TaigaMatsumoto/microduck/hardware/sts3032/README.md

# microduck × Feetech STS3032 換装検討

XL330-M288 を Feetech STS3032 に置き換えるための検討結果と変換マウントのCAD。
結論: **機械的には変換マウントで成立（ただし両軸版C036が前提）。電気は6V降圧が
必須、通信はバスドライバの書き換えが必要。制御はシム検証で既存ポリシーのまま
歩行・旋回・転倒復帰が成立**。

## 仕様比較

| | XL330-M288 (現行) | STS3032 |
|---|---|---|
| 外形 | 20 × 34 × 26 mm | 32 × 12 × 27.5 mm (小さい)  |
| 質量 | 18 g | 20 g (+2 g/個, 全体+30 g) |
| 電圧 | 〜6 V (実機は2S 6.6–8.2 Vで過電圧運用) | **4.8–6.0 V (2S直結不可)** |
| ストールトルク | 0.52 N·m@5 V (BAM同定では2S時±0.96 N·m相当) | **0.44 N·m@6 V (約半分)** |
| 無負荷速度 | ~104 rpm | 111 rpm@6 V |
| エンコーダ | 12bit 磁気 | 12bit 磁気 |
| 通信 | DYNAMIXEL Protocol 2.0 TTL 1 Mbps | **Feetech STS (SCS) TTL 1 Mbps — 非互換** |

## シミュレーション検証 (MuJoCo, allcollisionsモデル)

XMLアクチュエータを STS3032 相当 (forcerange ±0.44 N·m, 剛性 kp 0.25–0.45
N·m/rad, 質量+3.8%) に落として既存ONNXポリシーを実行:

| 構成 | 前進歩行(20s) | 旋回 | 転倒復帰 |
|---|---|---|---|
| XL330基準 (kp0.55 ±0.96) | 2.34 m | ○ | ○ |
| STS3032 kp0.45 ±0.44 | 2.09 m | ○ | ○ |
| STS3032 kp0.35 ±0.44 | 1.93 m | ○ | ○ |
| STS3032 kp0.25 ±0.44 | 1.25 m (ドリフト大) | △ | — |

→ トルク半減でも歩行は成立。歩速は約1割低下。実機ではBAMでSTS3032を同定して
`joints_properties.xml` にクラス追加→再学習が望ましいが、まず既存ポリシーで
動く見込みがある。

## 変換マウント (adapter_cad.py)

**前提: 両軸版 STS3032-C036 を使うこと。** 尾側の16×22×4ベアリング座 (XL330の
背面⌀16ボスの代替) はサーボ本体が軸線上を占有するためケージには作れず、後軸
に取り付けるスリーブで実現する。

| 部品 | 役割 |
|---|---|
| `cage` | XL330外形 (20×34×26, 軸位置=ホーン側端から9.5) を再現する角筒。M2×4貫通ボルト (実測: y±8 / z+7.5,−22.5, ⌀2) はそのまま流用。サーボは前面から挿入 |
| `horn_adapter` | ⌀16円盤。STSホーンに固定し、XL330ホーンパターン (4×⌀1.6下穴 @⌀12BC) を提供 |
| `tail_sleeve` | C036後軸に接着/圧入する⌀16スリーブ+フランジ。ベアリング内輪座 |

XL330側の界面寸法は `microduck_rl` の `xl330.stl` 断面解析による実測値。
STS3032側の `TODO_` 定数 (軸〜前端距離、ホーンBC、後軸径、タブ位置) は
**印刷前に必ず実物をノギスで実測して更新すること**。

既知の注意点:
- STS3032の全高27.5 > XL330奥行26。軸〜前端を8 mmとするとケース内に収まる
  計算だが、実測次第で尾側に≲1.5 mm突出しうる (シェル内クリアランス要確認)
- ホーンアダプタの円盤厚2.5 mmはXL330純正ホーンの座面高に合わせて要調整
  (駆動側リンクのオフセットがズレると関節原点がズレる)

## 機械以外の必要改修

1. **電源**: 2S (6.6–8.2 V) → 6.0 V 降圧コンバータ (連続5 A / ピーク10 A級) を
   追加。バッテリー電圧テレメトリはサーボ経由では取れなくなる (別途ADC)
2. **通信**: `duck-control/src/bus.rs` は DYNAMIXEL Protocol 2.0。Feetech STS
   レジスタマップ (Goal Position 0x2A 等) 用ドライバの追加実装が必要
3. **IMU**: `imu_to_dxl` ボードはDXLバス同居前提。STSバスとは混在不可のため
   IMUは別UARTに分離するか、ボード置き換え
4. **ゲイン**: robotdの `gain 200` はDXLレジスタ値。Feetech側の等価Pゲインは
   BAM同定 (bamはsts3215の同定例あり) で合わせ込む

## 出典

- STS3032 公称仕様 (32×12×27.5 mm / 20 g / 4.5 kg·cm@6 V / 4.8–6 V):
  Feetech公式・代理店各社の製品ページ (feetechrc.com, robotshop, switch-science)
- XL330界面寸法: 本リポジトリ経由で参照する `microduck_rl` の CADメッシュ実測

## 小型化編: STS3032に合わせて機体を縮める (scale_study.py)

「アダプタでXL330外形を維持」の対極として、機体そのものをSTS3032基準に
縮める場合の検討。

### 一様縮小はほぼ効かない

サーボの寸法比が非等方なため:

| 軸 | XL330 | STS3032 | 比 |
|----|---|---|-----|
| 幅 (脚の横幅を決める) | 20 | **12** | 0.60 |
| 長手 (リンク長を決める) | 34 | 32 | 0.94 |
| 奥行 | 26 | **27.5** | **1.06 (大きい!)** |

相似縮小の下限は最悪軸で決まり、奥行きはむしろ大きいので**単純な相似縮小は
成立しない**。現実の縮小は「レイアウト変更」が主役: 幅方向はサーボ厚12mm
を活かして大幅に痩せられる (股関節スタックの横幅 -30〜40%が狙える) 一方、
脚リンク長はサーボ全長でほぼ決まるため -5〜15%が現実的。

### スケール則 (リンク長 ×s のとき)

質量 ∝ s³、慣性 ∝ s⁵、静的必要トルク ∝ s⁴、歩行の固有振動数 ∝ 1/√s。
s=0.85 なら構造質量×0.61・必要トルク×0.52 — STS3032の0.44 N·mに対する
トルク余裕はXL330機の等価以上に回復する。**小型化はトルク半減の最良の対策
でもある**。

### シム実証: どこまで既存ポリシーが使えるか

一様スケール版MJCF (長さ×s, 質量×s³, 慣性×s⁵) + STS3032アクチュエータ
(kp0.35 ±0.44) で既存ONNXを実行:

| s | 立位10s | 歩行20s | 転倒復帰 |
|---|---|---|---|
| 1.00 | ○ | ○ 1.84 m | ○ |
| 0.90 | ○ | ○ 1.39 m | ○ |
| 0.85 | ○ | ○ 0.98 m | ○ |
| 0.80 | ○ | × 歩行が発火しない | × |
| 0.70 | ○ | × 同上 | × |

**結論: −15% (全高≈224 mm) までは既存ポリシーがそのまま動く。それ以下は
mjlabでの再学習が必須**(縮小MJCFはこのスクリプトの方法で生成できる)。

### 推奨手順

1. STS3032-C036実測 → adapter_cad.py確定 (アダプタ機で電装・ソフトを先に検証)
2. 骨格再レイアウト: 幅詰め優先・リンク長 −10〜15%、電池をNP-F550から
   小型2Sパックへ (質量見積り: 約800 g → 650–700 g)
3. 縮小MJCF生成 (scale_study.pyの変換) → BAMでSTS3032同定 →
   s<0.85を狙うならmjlab再学習、〜0.85なら既存ポリシーで起動確認から
4. 6 V電源系とFeetechバスドライバ (本編の改修リスト参照)

比較レンダ: `render_scale_compare.png` (s=1.00 vs s=0.85 vs 350ml缶)

## 再レイアウト具体案 (hip_module.py / layout_compare_front.png)

現行機のFK実測 (関節軸ワールド座標) から出発した数値レイアウト:

| 項目 | 現行 XL330 | 再レイアウト STS3032 | 差 |
|---|---|---|-----|
| 股ヨー軸間隔 | 35 mm | **26 mm** | −26% |
| ロール→ピッチ横距離 | 25 mm | 22 mm | −12% |
| 脚(ピッチ軸)間隔 | 85 mm | **70 mm** | −18% |
| 股まわり全幅 | ≈111 mm | ≈98 mm | −12% |
| 大腿/下腿リンク長 | 42.2 / 49.4 mm | ×0.88 (37.1 / 43.5) | −12% |

設計上の要点 (向きで得をする軸・しない軸):
- **ヨー軸(鉛直)・ロール軸(前後)**: サーボの12mm薄が横を向く → 大幅短縮
- **ピッチ軸(横)**: 横に出るのはサーボ高27.5mm (XL330は26) → **利得なし**。
  脚間隔短縮の主因はヨー間隔とロール段の詰めであり、当初想定の58mmは
  ここを見落とした過大見積り。70mmが正しい目標値

シム検証 (scale_studyの手法で再レイアウトMJCFを生成・既存ONNX実行):

| 構成 | 立位 | 歩行20s | 転倒復帰 |
|---|---|---|---|
| 一様 s=0.88 (脚間隔74.6) | ○ | ○ 1.27 m | ○ |
| **再レイアウト 脚間隔69.8 + s=0.88** | ○ | ○ 1.06 m | ○ |
| 再レイアウト 脚間隔75.8 + s=1.00 | ○ | ○ 1.84 m | ○ |

→ **幅−18%・リンク−12%でも既存ポリシーのまま歩行・復帰が成立**。幅詰め
単独 (s=1.00) なら歩行性能の低下ゼロ。

`hip_module.py` は左股ヨー→ロール→ピッチ3軸クラスタの概念CAD
(hip_module_assy.step)。ブラケット2点+サーボモック3個で上記レイアウトを
実体化したもの。ホーンBC等は ★要実測 のままのレイアウト検討グレード。

## 3Dプリントガイド (print_plate.py)

`print/` に印刷向きに回転済みの個別STL、`print_plate_sts3032.stl` に
全部品1プレート (159×38 mm) を出力する。QA結果: 全5部品 水密、
オーバーハングほぼゼロ、PETG想定で合計約19 g。

| 部品 | 向き | サポート | 備考 |
|---|---|---|---|
| cage | トンネル軸を鉛直 | 不要 | ボルト穴・トンネルとも垂直に出る |
| horn_adapter | XLパターン面を下 | 不要 | 座ぐりが上向き |
| tail_sleeve | フランジをベッドに | 不要 | |
| yaw_bracket | L字を寝かせて平置き | 不要 | 一定断面18mm。積層方向に強い |
| roll_bracket | ホーン円盤面を下 | seat下面のみ推奨 | |

推奨設定 (PETG または PLA+):
- レイヤー 0.16 mm / 壁 4周 (幅1.6mm — ケージ側壁3.75mmがほぼ無限壁になる)
- インフィル 40% gyroid / ブリム: cage と tail_sleeve に 3 mm
- 穴は意図的に小さめ: ⌀1.6下穴 → M2セルフタップ直入れ、⌀2.2 → M2通し。
  きつい場合は1.5/2.0mmドリルでさらい

**印刷順の推奨**:
1. **cage を先に1個** — XL330側界面は実測確定値なので、手持ちのXL330・
   既存プリント部品・M2ボルトとの嵌合確認が今すぐできる (サーボ不要)
2. horn_adapter / tail_sleeve / ブラケット2点は ★TODO_寸法 (STSホーンBC・
   後軸径など) が実測未確定。**C036現物のノギス実測 → adapter_cad.py /
   hip_module.py 更新 → 再生成してから**が確実。形状確認目的なら現状版でも可
