TaigaMatsumoto/microduck/hardware/sts3032/layout_compare_front.png

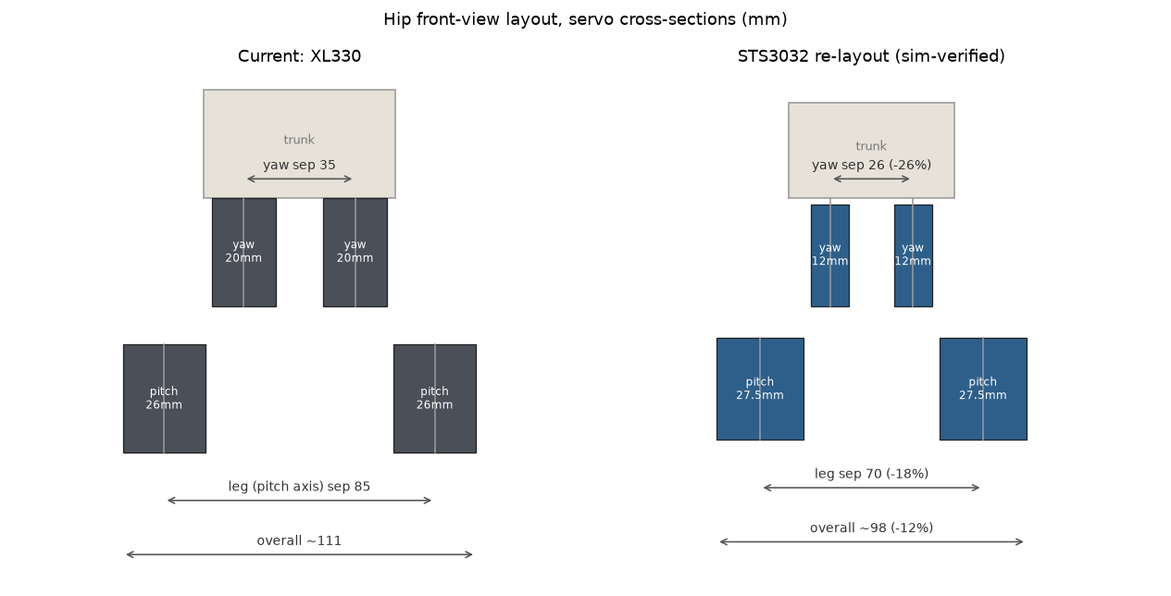
hardware/sts3032/layout_compare_front.png
