TaigaMatsumoto/microduck/hardware/sts3032/render_assy.png

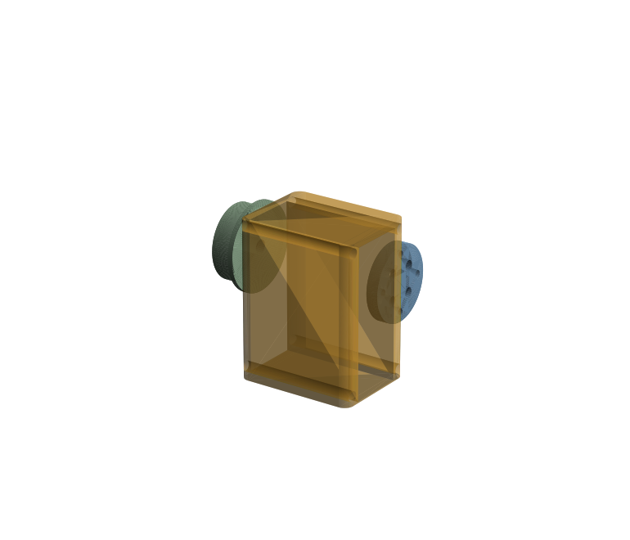
hardware/sts3032/render_assy.png
