TaigaMatsumoto/microduck/hardware/sts3032/render_cage.png

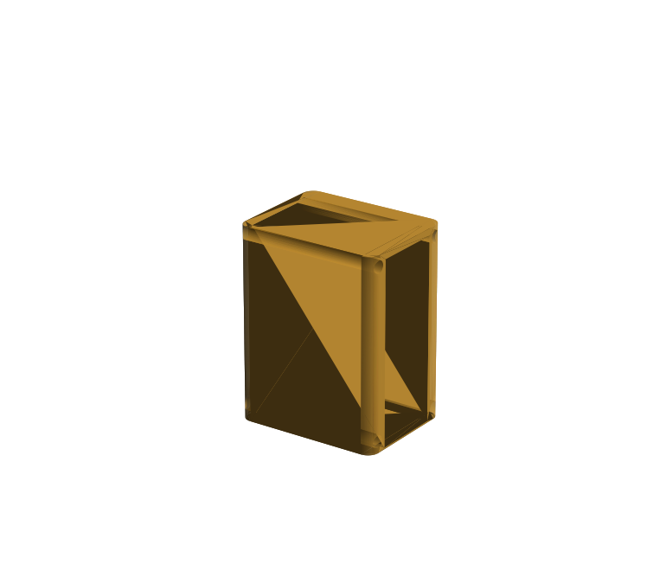
hardware/sts3032/render_cage.png
