TaigaMatsumoto/microduck/hardware/sts3032/render_full_opaque.png

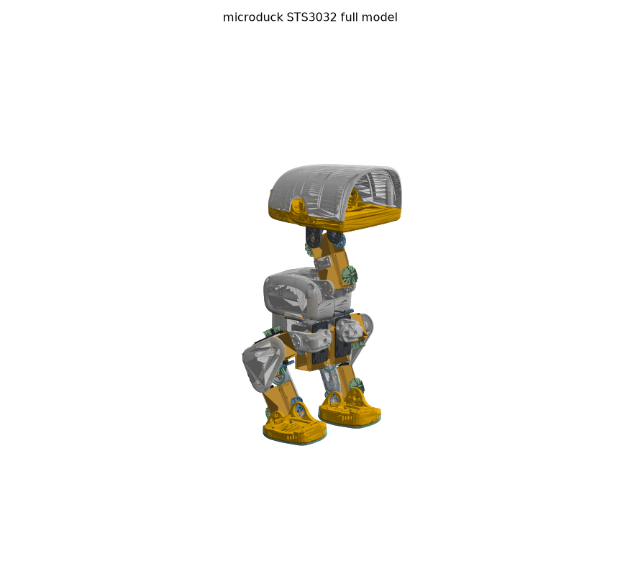
hardware/sts3032/render_full_opaque.png
