TaigaMatsumoto/microduck/hardware/sts3032/render_full_xray_front.png

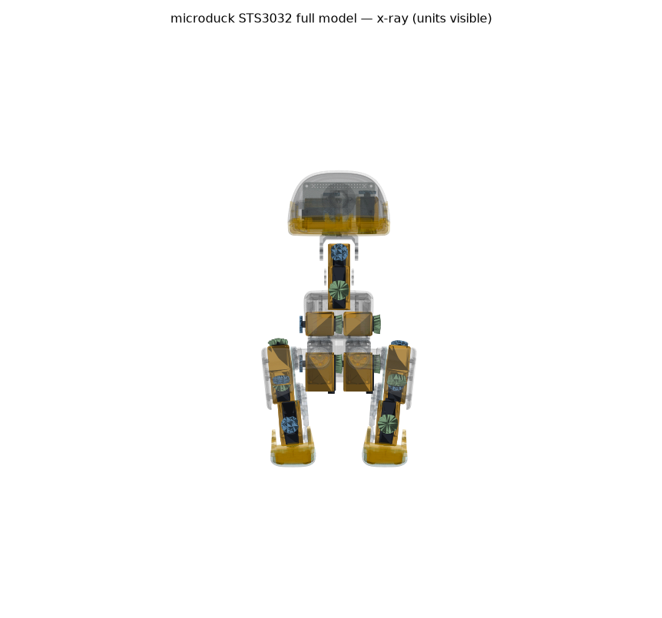
hardware/sts3032/render_full_xray_front.png
