TaigaMatsumoto/microduck/hardware/sts3032/render_hip_module.png

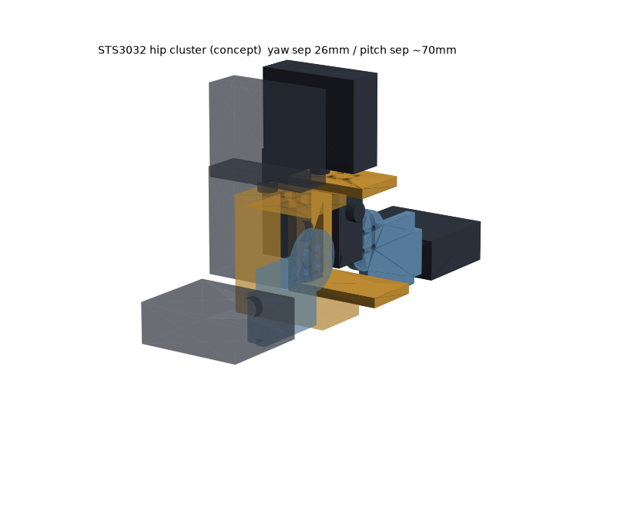
hardware/sts3032/render_hip_module.png
