TaigaMatsumoto/microduck/hardware/sts3032/render_hip_module_front.png

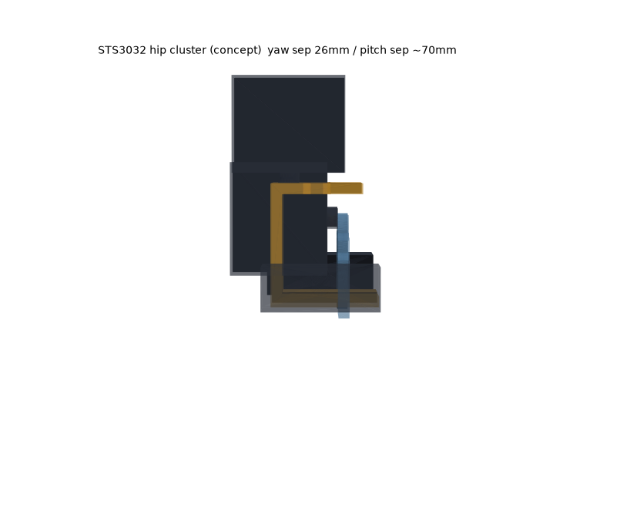
hardware/sts3032/render_hip_module_front.png
