TaigaMatsumoto/microduck/hardware/sts3032/render_scale_compare.png

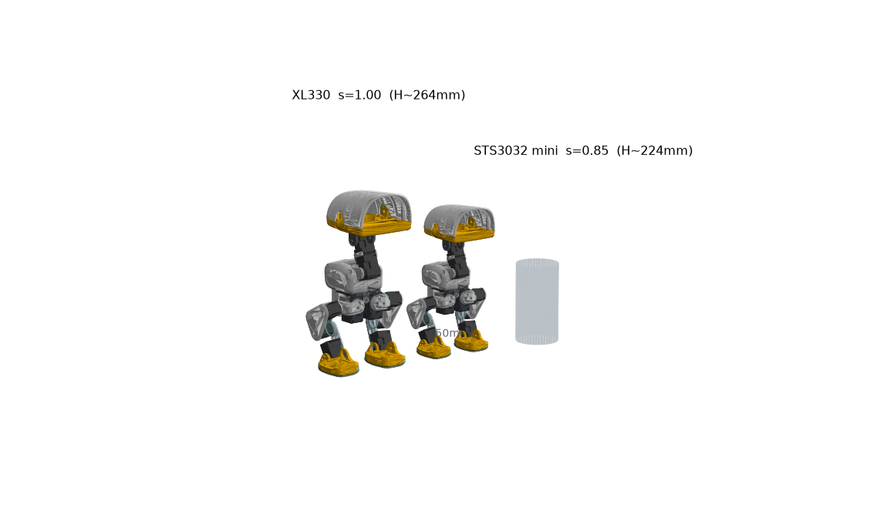
hardware/sts3032/render_scale_compare.png
