TaigaMatsumoto/microduck/hardware/sts3032/render_sleeve.png

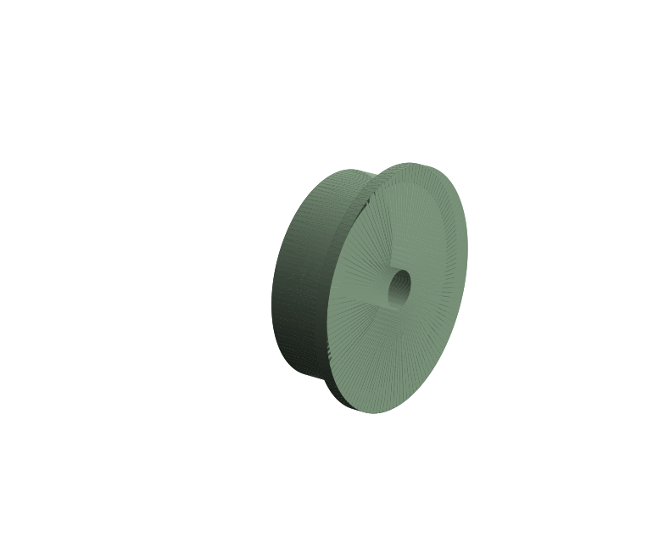
hardware/sts3032/render_sleeve.png
