TaigaMatsumoto/microduck/hardware/sts3032/hip_module_assy.step

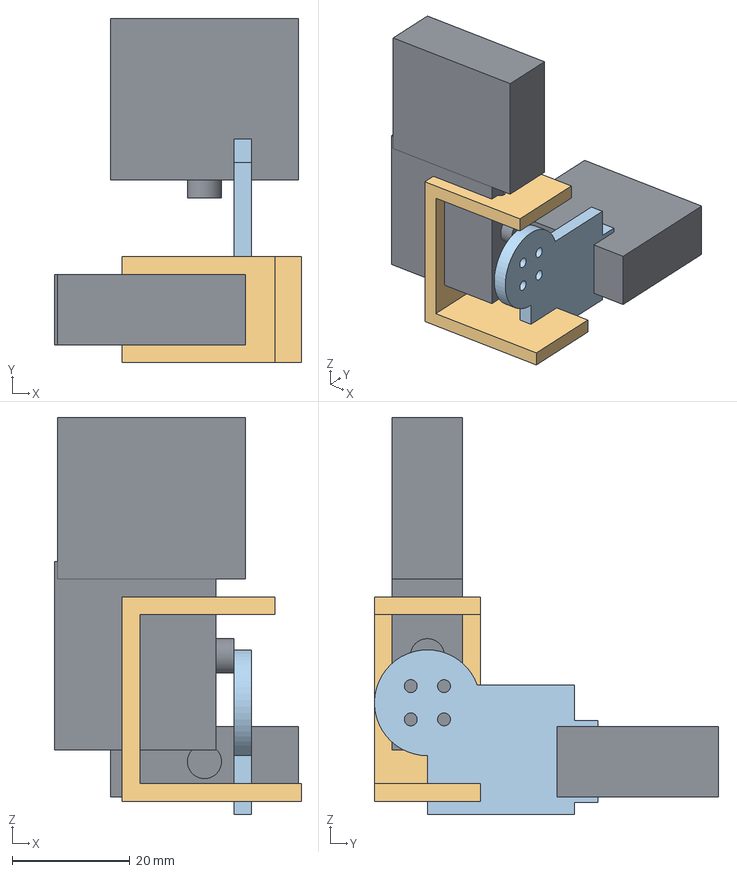
[picture p10: CAD file, 2026-08-29]
hardware/sts3032/hip_module_assy.step
42.0 x 58.5 x 67.5 mm
yaw_servo
yaw_bracket
roll_servo
roll_bracket
pitch_servo
