TaigaMatsumoto/microduck/hardware/sts3032/unit_assy.step

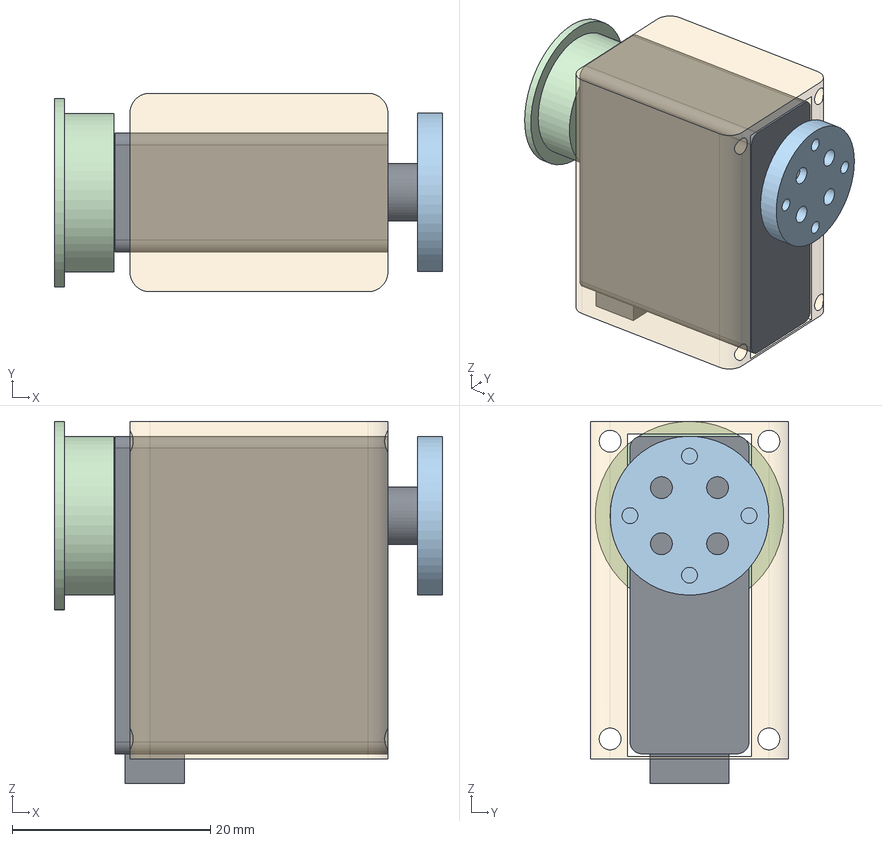
[picture p11: CAD file, 2026-08-29]
hardware/sts3032/unit_assy.step
39.1 x 20.0 x 36.5 mm
cage
sts3032_c036
horn_adapter
tail_sleeve
