TaigaMatsumoto/microduck/hardware/sts3032/print/roll_bracket.stl

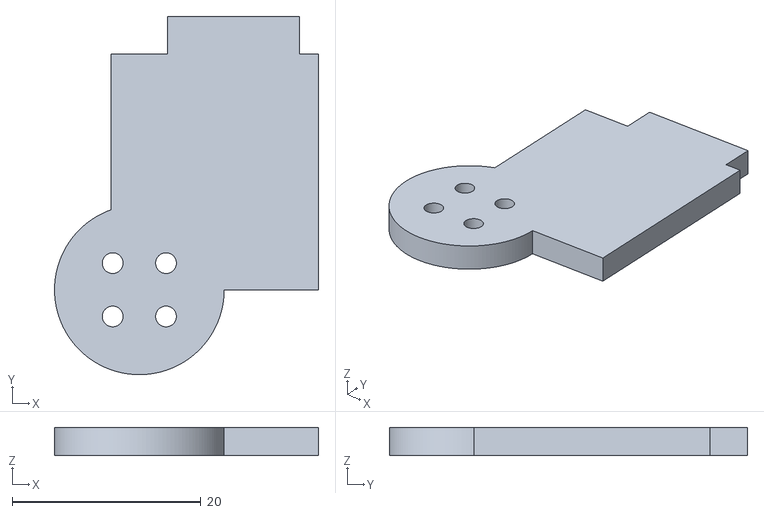
[picture p12: CAD file, 2026-08-30]
hardware/sts3032/print/roll_bracket.stl
28.0 x 38.0 x 3.00
