TaigaMatsumoto/microduck/hardware/sts3032/print_plate_sts3032.stl

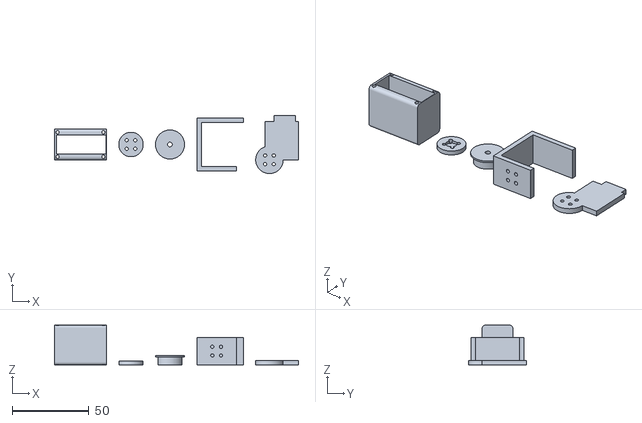
[picture p13: CAD file, 2026-08-30]
hardware/sts3032/print_plate_sts3032.stl
159.5 x 38.0 x 26.0
