TaigaMatsumoto/microduck/hardware/sts3032/print/yaw_bracket.stl

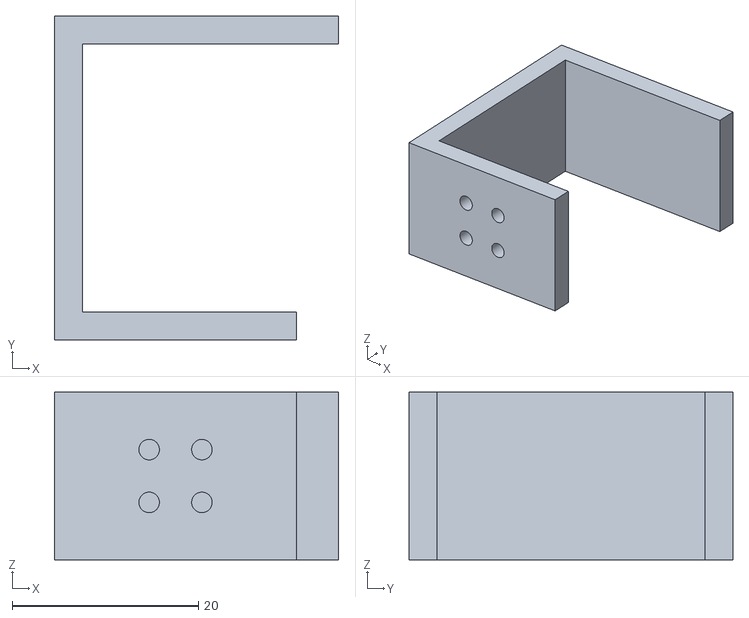
[picture p14: CAD file, 2026-08-30]
hardware/sts3032/print/yaw_bracket.stl
30.5 x 34.8 x 18.0
