TaigaMatsumoto/microduck/hardware/sts3032/tail_sleeve.step

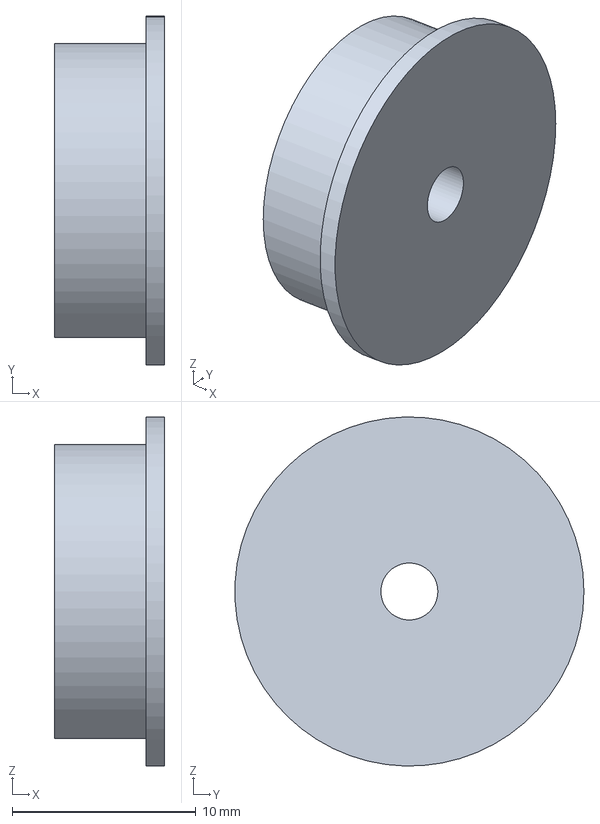
[picture p15: CAD file, 2026-08-29]
hardware/sts3032/tail_sleeve.step
6.00 x 19.0 x 19.0 mm
