TaigaMatsumoto/microduck/hardware/sts3032/cage.step

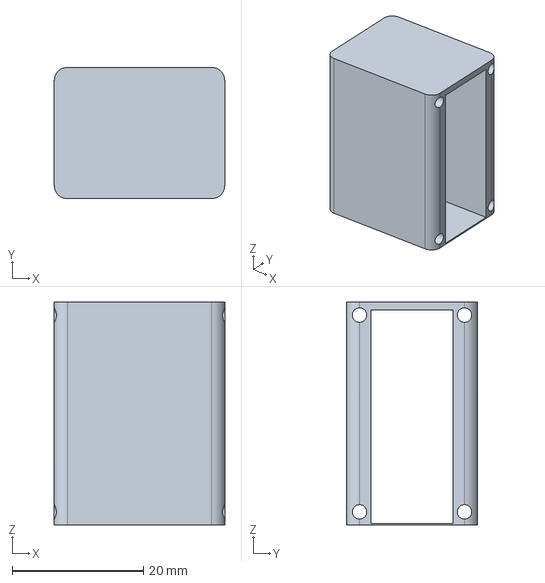
[picture p16: CAD file, 2026-08-29]
hardware/sts3032/cage.step
26.0 x 20.0 x 34.0 mm
