TaigaMatsumoto/microduck/hardware/sts3032/horn_adapter.step

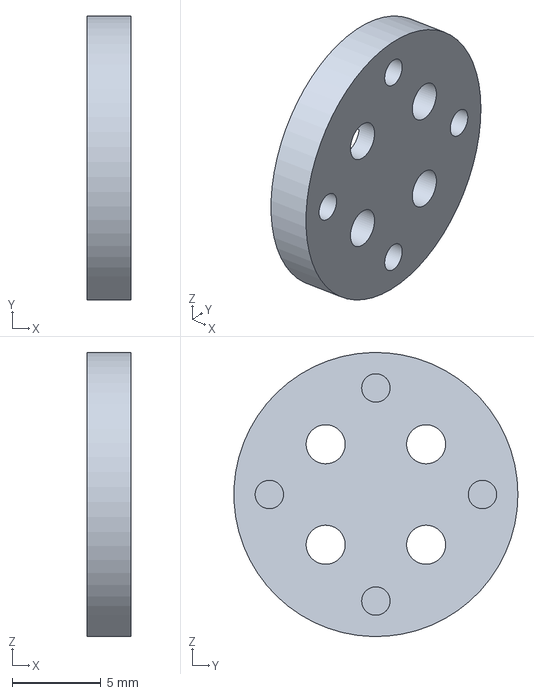
[picture p17: CAD file, 2026-08-29]
hardware/sts3032/horn_adapter.step
2.50 x 16.0 x 16.0 mm
