TaigaMatsumoto/microduck/(list of files, cad)

Other CAD files:
hardware/sts3032/cage.stl
hardware/sts3032/hip_module_assy.stl
hardware/sts3032/horn_adapter.stl
hardware/sts3032/print/cage.stl
hardware/sts3032/print/horn_adapter.stl
hardware/sts3032/print/tail_sleeve.stl
hardware/sts3032/tail_sleeve.stl
hardware/sts3032/unit_assy.stl
