TaigaMatsumoto/microduck/hardware/sts3032/render_print_plate.png

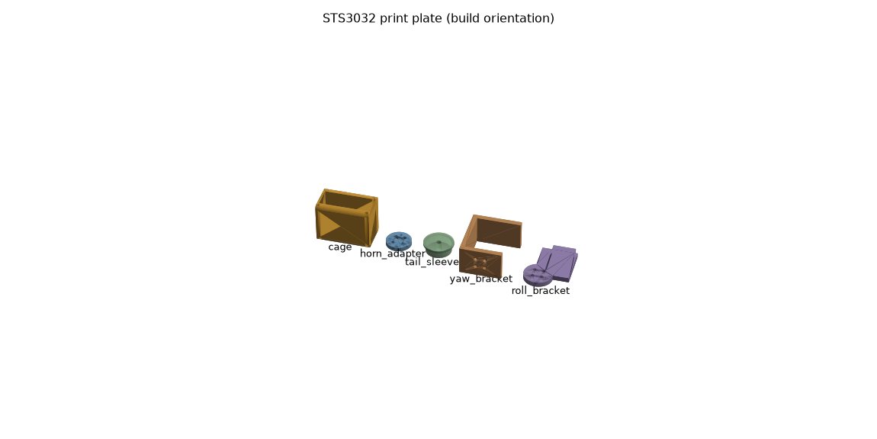
hardware/sts3032/render_print_plate.png
