TaigaMatsumoto/microduck/(commit log)

2026-08-28 Add duck-viewer: a standalone web view of the baked assembly model
    robotctl's terminal monitor is the only place the robot's visual model can
    currently be seen, and a terminal cannot answer "how big is this thing?".
    duck-viewer.py wraps the same committed duck.bin bake in a self-contained
    HTML page: Three.js orbit view, a centimetre grid and ruler, everyday-object
    scale references (drink can, bottle, phone) and per-joint pose sliders with
    ranges read from the kinematics MJCF, so the assembly and its real-world
    size can be judged in any browser with nothing else installed.
    Claude-Session: https://claude.ai/code/session_01WT6EZeCncbWhBQc4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
2026-08-28 duck-viewer: embed the full-resolution CAD meshes when an MJCF is given
    The first cut drew robotctl's duck.bin, a bake decimated for a terminal, and
    looked the part. Given the app repository's robot_walk.xml the viewer now
    embeds the STLs at CAD resolution (~430k triangles, welded to ~6.6 MB of
    page), keeps duck.bin as the no-arguments fallback, and gains an x-ray
    toggle that turns the shells to glass so the enclosed electronics read.
    Parts also carry their material alpha now instead of dropping it.
    Claude-Session: https://claude.ai/code/session_01WT6EZeCncbWhBQc4y973CM
2026-08-28 duck-viewer: --sim embeds a browser physics sim the real policies walk in
    The viewer gains a walking-simulation mode: MuJoCo compiled to WebAssembly
    (the mujoco npm package) steps the training repository's full-collision
    model at 200 Hz inside the page, while alpha_walking.onnx and
    alpha_stand.onnx run as plain JavaScript — they are small enough MLPs that
    Gemm+Elu by hand beats shipping an inference runtime. The control loop
    reproduces robotd's contract: the 61-float observation layout of
    duck-control's obs.rs, targets = home + action at 50 Hz, and the
    walk/stand switch on command magnitude, which doubles as fall recovery
    because the standing network is the get-back-up network. Drive it wi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
2026-08-28 duck-viewer: AR modes — composite the walking sim over camera or photo
    Three ways to put the simulated duck into the real world, in the sim
    panel's new AR section:
    - カメラ: getUserMedia rear-camera feed behind a transparent canvas.
    - 写真: any picked picture as the backdrop, same compositing.
    - WebXR AR (where the device supports immersive-ar): hit-test finds a real
    surface, a tap places the duck on it at true scale, and re-placing lands
    the duck itself on the reticle rather than the origin it walked from.
    With no DOM overlay a second tap toggles walking, so it stays drivable.
    The composite modes are deliberately fixed-shot: the camera stops following
    the duck so the user can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
2026-08-28 duck-viewer: 撮影 AR path for hosts that block the live camera
    On iPhone the artifact renders inside an embedding frame that doesn't grant
    the camera permission, so getUserMedia can never succeed there. The AR
    section gains a 撮影 button backed by a capture=environment file input: the
    OS camera app takes the photo and the page composites onto it — no
    getUserMedia, no permission for an embedding frame to strip. Live-camera
    failures now say what actually went wrong (permission stripped, no device)
    and point at 撮影 instead of a generic apology.
    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
2026-08-28 duck-viewer: escape the embedding frame so the live camera can prompt
    The page detects when it runs inside an embedding frame (where the camera
    permission is stripped and getUserMedia can never succeed) and offers
    別タブで開く: the artifact is served from its own origin, so opening
    location.href as a top-level tab restores the browser's own camera prompt
    — on iPhone Safari included. Pop-up blocked → the URL is copied (or shown)
    with instructions instead. Camera failures now say the embedded case and
    the denied-permission case apart, with the iOS Safari setting spelled out.
    Claude-Session: https://claude.ai/code/session_01WT6EZ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
2026-08-28 duck-viewer: manual escape routes and a diagnosis line for the live camera
    window.open can be silently swallowed by an embedding shell, so the AR
    section now also carries a real same-origin anchor (which the frame
    runtime does not intercept), the page's own URL in a copyable field, and
    a copy button with an execCommand fallback for clipboards that refuse the
    API. A one-line diagnosis (build date, embedded vs top-level, live-API
    availability) makes phone-side failures reportable from a screenshot.
    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
2026-08-28 web: commit the built viewer so a CDN can serve it as a plain page
    The artifact host renders the viewer inside an embedding frame that strips
    the camera permission, so the live-camera AR mode can never prompt there.
    Served instead as a plain top-level page — via jsDelivr/githack pinned to a
    commit, or GitHub Pages — the browser's own camera prompt works, WebXR
    included. This is the built output of:
    scripts/duck-viewer.py <app repo>/robot_walk.xml web/duck-viewer.html --sim
    Regenerate and re-commit when the viewer script or the model changes.
    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
2026-08-28 bake-duck-usdz: a walking USDZ for iPhone AR Quick Look
    iOS has no WebXR, but Quick Look places a usdz on a real surface at true
    scale. The baker rolls alpha_walking.onnx out in MuJoCo with a forward+yaw
    command tuned so one lap closes on itself (the loop returns within ~3 cm of
    its start), records every body's world transform at 25 fps, and writes the
    decimated visual meshes with those transforms as time-sampled USD. The
    committed web/duck-walk.usdz is 21.8 s of a real-size microduck walking a
    circle, verified against MuJoCo poses at bake time.
    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
2026-08-28 bake-duck-usdz: draw both faces — Quick Look culled the CAD's mixed winding
    The STL exports don't wind consistently, and Quick Look's default
    single-sided rendering turned every back-wound face into a hole in the
    shells. doubleSided on each mesh is the fix.
    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
2026-08-28 bake-duck-usdz: emit both windings — RealityKit ignores doubleSided
    The previous fix set doubleSided, which Quick Look's renderer does not
    honor; the shells still lost their back-wound faces. Each triangle now
    ships in both windings: with culling on exactly one copy faces the camera,
    so both sides render without z-fighting and each lights by its own normal.
    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
2026-08-28 duck-viewer: gyro AR — interactive AR steering for phones without WebXR
    The live-camera composite gains rotational tracking: with ジャイロ追従 on,
    DeviceOrientation (permission-gated on iOS) drives the view so the phone
    can look around the scene, a tap projects through the camera onto the
    virtual floor and places the duck there — WebXR's gesture, same live sim —
    and a vertical drag tunes the camera height, since enabling the mode also
    collapses the panel out of the way of the very floor being tapped. The
    folded bar's mini pad does the driving. Quick Look stays labelled 再生のみ;
    this mode is the operate-in-AR answer for iPhone.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
2026-08-29 hardware: STS3032 conversion study and adapter CAD
    Can the duck be built on Feetech STS3032s? The study answers: mechanically
    yes through a ghost-of-XL330 adapter, with three findings that shape it.
    The servo is smaller than an XL330 in every dimension, so a cage that
    reproduces the XL330 envelope and its measured interface (axis 9.5 mm from
    the head end, four M2 through-bolts at y±8 / z+7.5,-22.5, ⌀16 horn boss
    with 4×⌀1.6 on a ⌀12 circle — all sectioned out of xl330.stl) mounts into
    every existing part unchanged. The tail bearing seat cannot live on the
    cage — the servo body occupies the axis line — so the double-shaft C036
    variant is required, carrying a sleeve that becomes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
    [cage.step, cage.stl, horn_adapter.step, horn_adapter.stl, tail_sleeve.step, tail_sleeve.stl]
2026-08-29 hardware: STS3032 conversion unit assembly model
    unit_assy.py mocks the STS3032-C036 from catalog dimensions and assembles
    it with the three adapter parts into one model: a coloured STEP assembly
    for CAD, a combined STL, assembled/exploded/XL330-overlay renders, and an
    AR Quick Look usdz so the unit can be held against a real servo at true
    scale. The servo mock is deliberately marked as visualization-grade — the
    printable truth stays adapter_cad.py after its TODO_ dimensions are
    measured off real hardware.
    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
    [unit_assy.step, unit_assy.stl]
2026-08-29 hardware: how small can an STS3032 duck get — scaling study
    Uniform shrink is a dead end the numbers make obvious: the STS3032 is
    0.60x an XL330 across the width but 1.06x in depth, so similarity scaling
    bottoms out immediately and real gains come from re-layout (the 12 mm
    servo lets hip stacks slim by a third; link lengths, set by servo length,
    give up only 5-15%). Scaling laws favor the swap — at s=0.85 required
    torque falls to 0.52x while the servo keeps its 0.44 Nm.
    scale_study.py makes the question empirical: it generates uniformly
    scaled MJCFs (lengths x s, masses x s^3, inertias x s^5) with
    STS3032-class actuation and runs the shipped policies. Down to s=0.85
    they stand, walk and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
2026-08-29 hardware: concrete hip re-layout for the STS3032 duck
    Numbers first: FK on the current model puts the hip-yaw axes 35 mm apart
    and the legs 85 mm. Which servo faces matter fell out of the orientation
    audit — yaw and roll turn the STS3032's 12 mm thickness sideways and
    shrink, while pitch turns its 27.5 mm height sideways and gains nothing;
    the naive 58 mm leg-spacing target died on that fact and 70 mm is the
    honest one. The validated layout (yaw 26 / legs 70 / links x0.88) walks
    and recovers on the shipped policies in MuJoCo, and narrowing alone at
    full link length costs no gait speed at all.
    hip_module.py turns the layout into a concept assembly — two brackets and
    three servo mocks —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
    [hip_module_assy.step, hip_module_assy.stl]
2026-08-30 hardware: print-ready plate and QA for the STS3032 parts
    print_plate.py rotates each part into its support-minimal build
    orientation (the cage tunnel goes vertical so every hole prints clean;
    the yaw bracket lies flat as its constant-18mm L-section), lays all five
    out on one 159x38mm plate, and audits them — watertight across the set,
    overhangs near zero, ~19g of PETG total. The README's print guide keeps
    the honest ordering: the cage's XL330 side is measured truth and worth
    printing today as a fit check; the servo-facing parts wait on calipers.
    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
    [cage.stl, horn_adapter.stl, print_plate_sts3032.stl, roll_bracket.stl, tail_sleeve.stl, yaw_bracket.stl]
2026-08-30 hardware: STS3032 full-robot assembly model
    full_model.py swaps every one of the fifteen XL330 instances in the
    current duck's visual model for the conversion unit — cage, servo mock,
    horn adapter, tail sleeve — dropped in at the instance pose, which works
    precisely because the adapter was designed in xl330.stl's own frame. Out
    come the standing full-body STL, an AR Quick Look usdz at true scale, and
    renders including the x-ray view where the shells go glassy and all
    fifteen amber cages show in place. Unit meshes are decimated once and
    instanced to keep the usdz phone-sized; the 37MB STL stays regenerable
    rather than committed.
    Clau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
